6DeadZero9/IW_board_v2.0/IW_board_v2.0.kicad_pcb

## KiCad design IW_board_v2.0.kicad_pcb (2023-08-23)

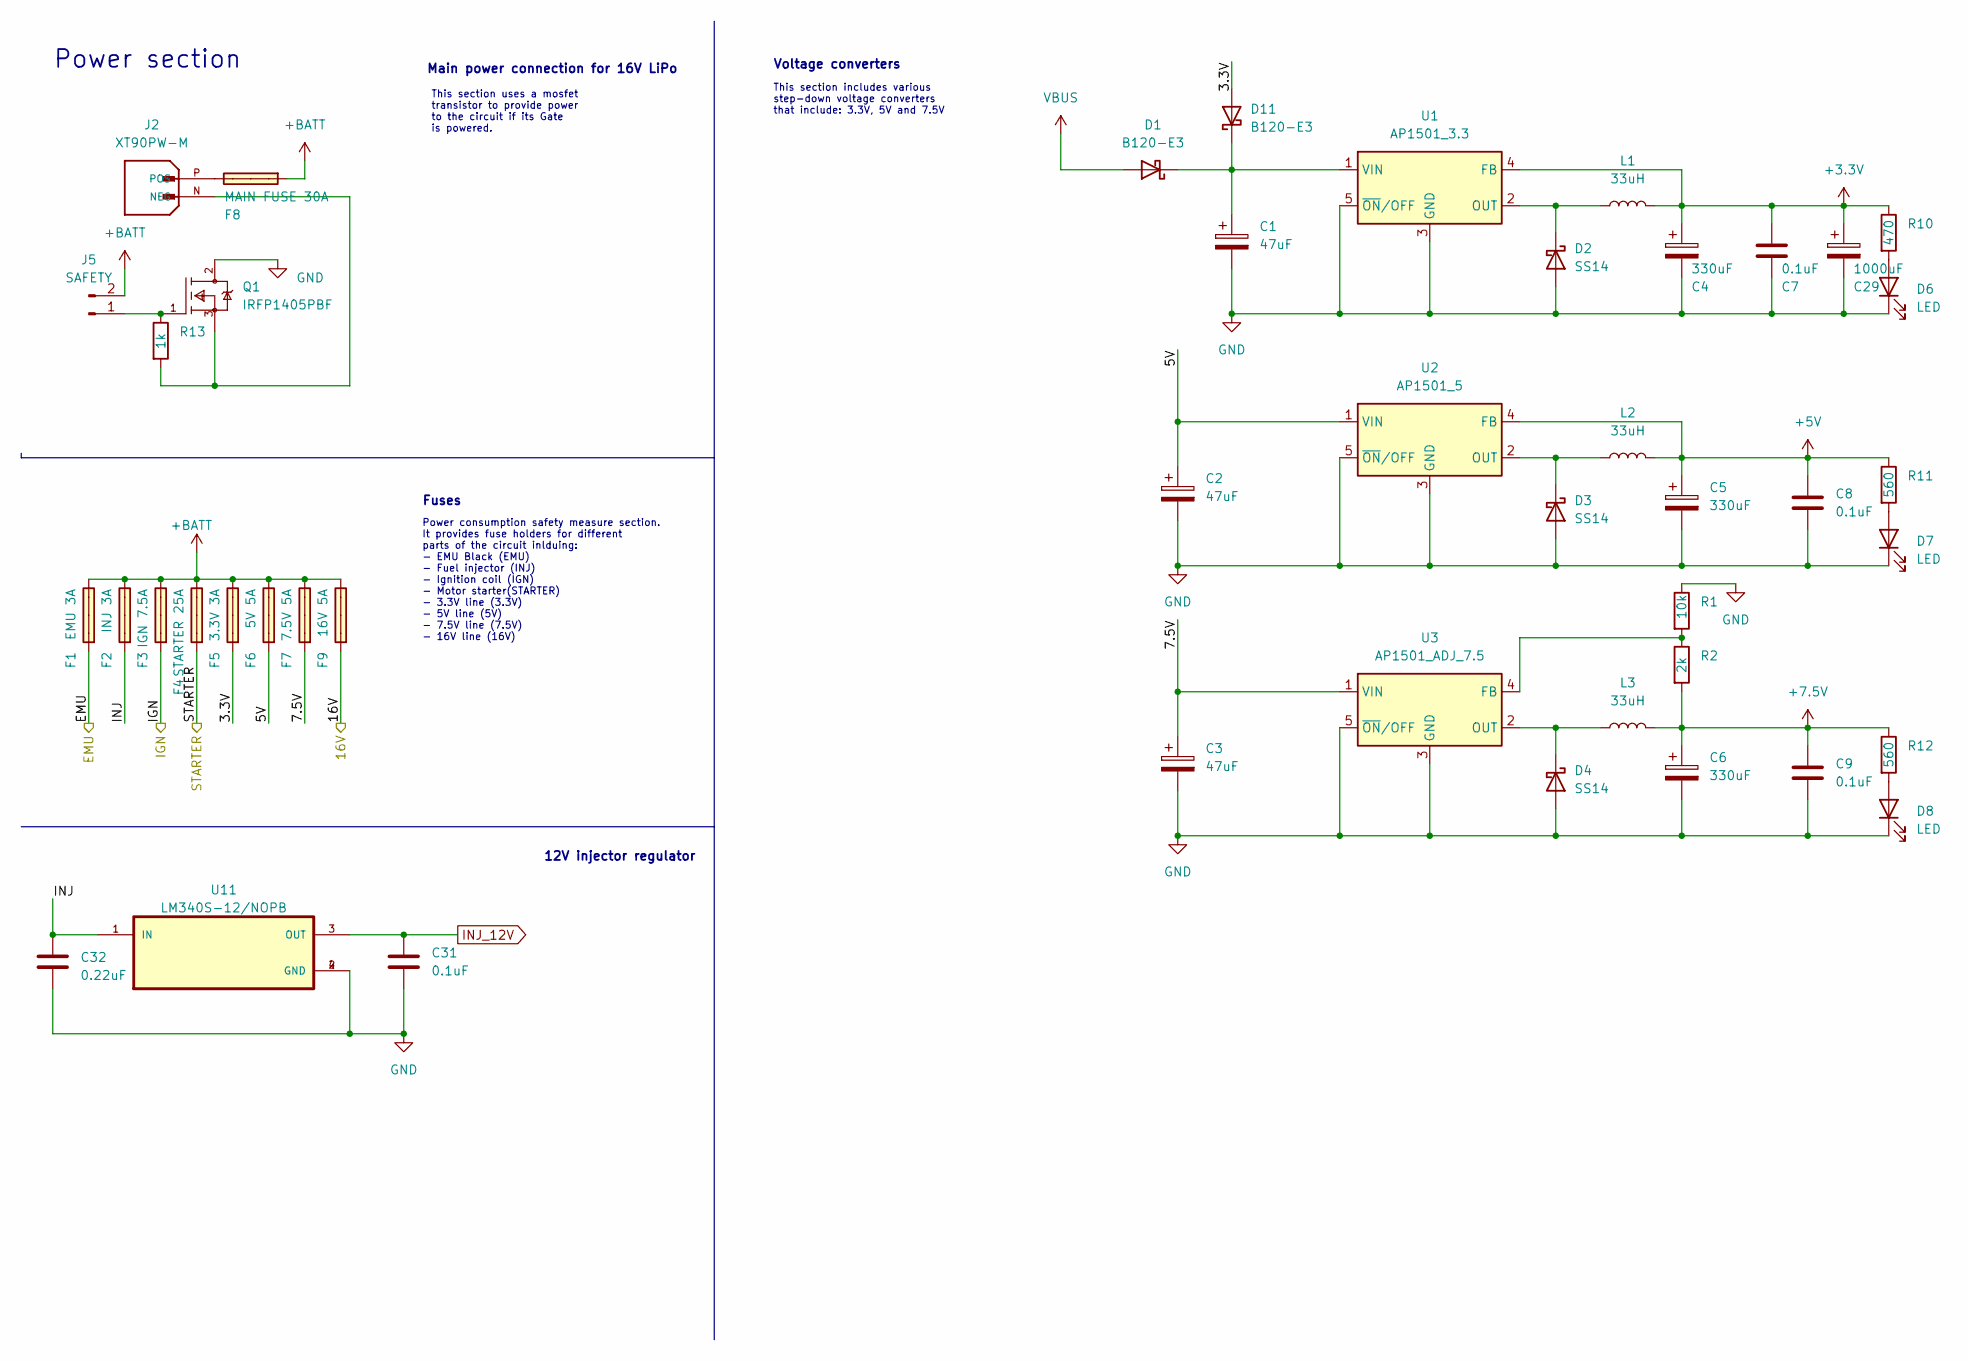
[picture p1: schematic pwr.kicad_sch, Iron Warriors v2.0]

Parts:
C1, C2, C3: 47uF; CP_Elec_6.3x5.8
C4, C5, C6: 330uF; CP_Elec_10x10
C7, C8, C9, C31: 0.1uF; C_0603_1608Metric
C29: 1000uF; CP_Radial_D10.0mm_P7.50mm
C32: 0.22uF; C_0603_1608Metric
D1, D11: B120-E3; D_SMA
D2, D3, D4: SS14; D_SMA
D6, D7, D8: LED; LED_0603_1608Metric
F1: EMU 3A; FUSE_3557-2
F2: INJ 3A; FUSE_3557-2
F3: IGN 7.5A; FUSE_3557-2
F4: STARTER 25A; FUSE_3557-2
F5: 3.3V 3A; FUSE_3557-2
F6: 5V 5A; FUSE_3557-2
F7: 7.5V 5A; FUSE_3557-2
F8: MAIN FUSE 30A; FUSE_3557-2
F9: 16V 5A; FUSE_3557-2
J2: XT90PW-M; AMASS_XT90PW-M
J5: SAFETY; TerminalBlock_Phoenix_MPT-0,5-2-2.54_1x02_P2.54mm_Horizontal
L1, L2, L3: 33uH; L_Bourns_SRR1208_12.7x12.7mm
Q1: IRFP1405PBF; TO247AC; mouser part number 942-IRFP1405PBF; digikey description MOSFET N-CH 55V 95A TO247AC
R1: 10k; R_0603_1608Metric
R2: 2k; R_0603_1608Metric
R10: 470; R_0603_1608Metric
R11, R12: 560; R_0603_1608Metric
R13: 1k; R_0603_1608Metric
U1: AP1501_3.3; TO-263-5_TabPin3
U2: AP1501_5; TO-263-5_TabPin3
U3: AP1501_ADJ_7.5; TO-263-5_TabPin3
U11: LM340S-12/NOPB; TO254P1524X483-4N

Connections:
+3.3V: C4.1, C7.1, C29.1, L1.2, R10.1, U1.4 (FB); also elsewhere on the board
+5V: C5.1, C8.1, L2.2, R11.1, U2.4 (FB); also elsewhere on the board
+7.5V: C6.1, C9.1, L3.2, R2.2, R12.1; also elsewhere on the board
+BATT: F1.3, F2.3, F3.3, F4.3, F5.3, F6.3, F7.3, F8.1, F9.3, J5.2
/IO/EMU: F1.1; also elsewhere on the board
/IO/IGN: F3.1; also elsewhere on the board
/IO/STARTER: F4.1; also elsewhere on the board
/PWR/3.3V: D11.2 (A), F5.1
/PWR/5V: C2.1, F6.1, U2.1 (VIN)
/PWR/7.5V: C3.1, F7.1, U3.1 (VIN)
/PWR/16V: F9.1; also elsewhere on the board
/PWR/INJ: C32.1, F2.1, U11.1 (IN)
GND: C1.2, C2.2, C3.2, C4.2, C5.2, C6.2, C7.2, C8.2, C9.2, C29.2, C31.2, C32.2, D2.2 (A), D3.2 (A), D4.2 (A), D6.1 (K), D7.1 (K), D8.1 (K), Q1.2 (D), R1.1, U1.3 (GND), U1.5 (~ON/OFF), U2.3 (GND), U2.5 (~ON/OFF), U3.3 (GND), U3.5 (~ON/OFF), U11.2 (GND), U11.4 (GND); also elsewhere on the board
INJ_12V: C31.1, U11.3 (OUT); also elsewhere on the board
unnamed: C1.1, D1.1 (K), D11.1 (K), U1.1 (VIN)
unnamed: D2.1 (K), L1.1, U1.2 (OUT)
unnamed: D3.1 (K), L2.1, U2.2 (OUT)
unnamed: D4.1 (K), L3.1, U3.2 (OUT)
unnamed: D6.2 (A), R10.2
unnamed: D7.2 (A), R11.2
unnamed: D8.2 (A), R12.2
unnamed: J2.N (NEG), Q1.3 (S), R13.2
unnamed: F8.3, J2.P (POS)
unnamed: J5.1, Q1.1 (G), R13.1
unnamed: R1.2, R2.1, U3.4 (FB)
VBUS: D1.2 (A); also elsewhere on the board

Notes on the sheet:
This section includes various step-down voltage converters that include: 3.3V, 5V and 7.5V
Power consumption safety measure section. It provides fuse holders for different parts of the circuit inlduing: - EMU Black (EMU) - Fuel injector (INJ) - Ignition coil (IGN) - Motor starter(STARTER) - 3.3V line (3.3V) - 5V line (5V) - 7.5V line (7.5V) - 16V line (16V)
This section uses a mosfet transistor to provide power to the circuit if its Gate is powered.
Power section
12V injector regulator
Main power connection for 16V LiPo
Fuses
Voltage converters

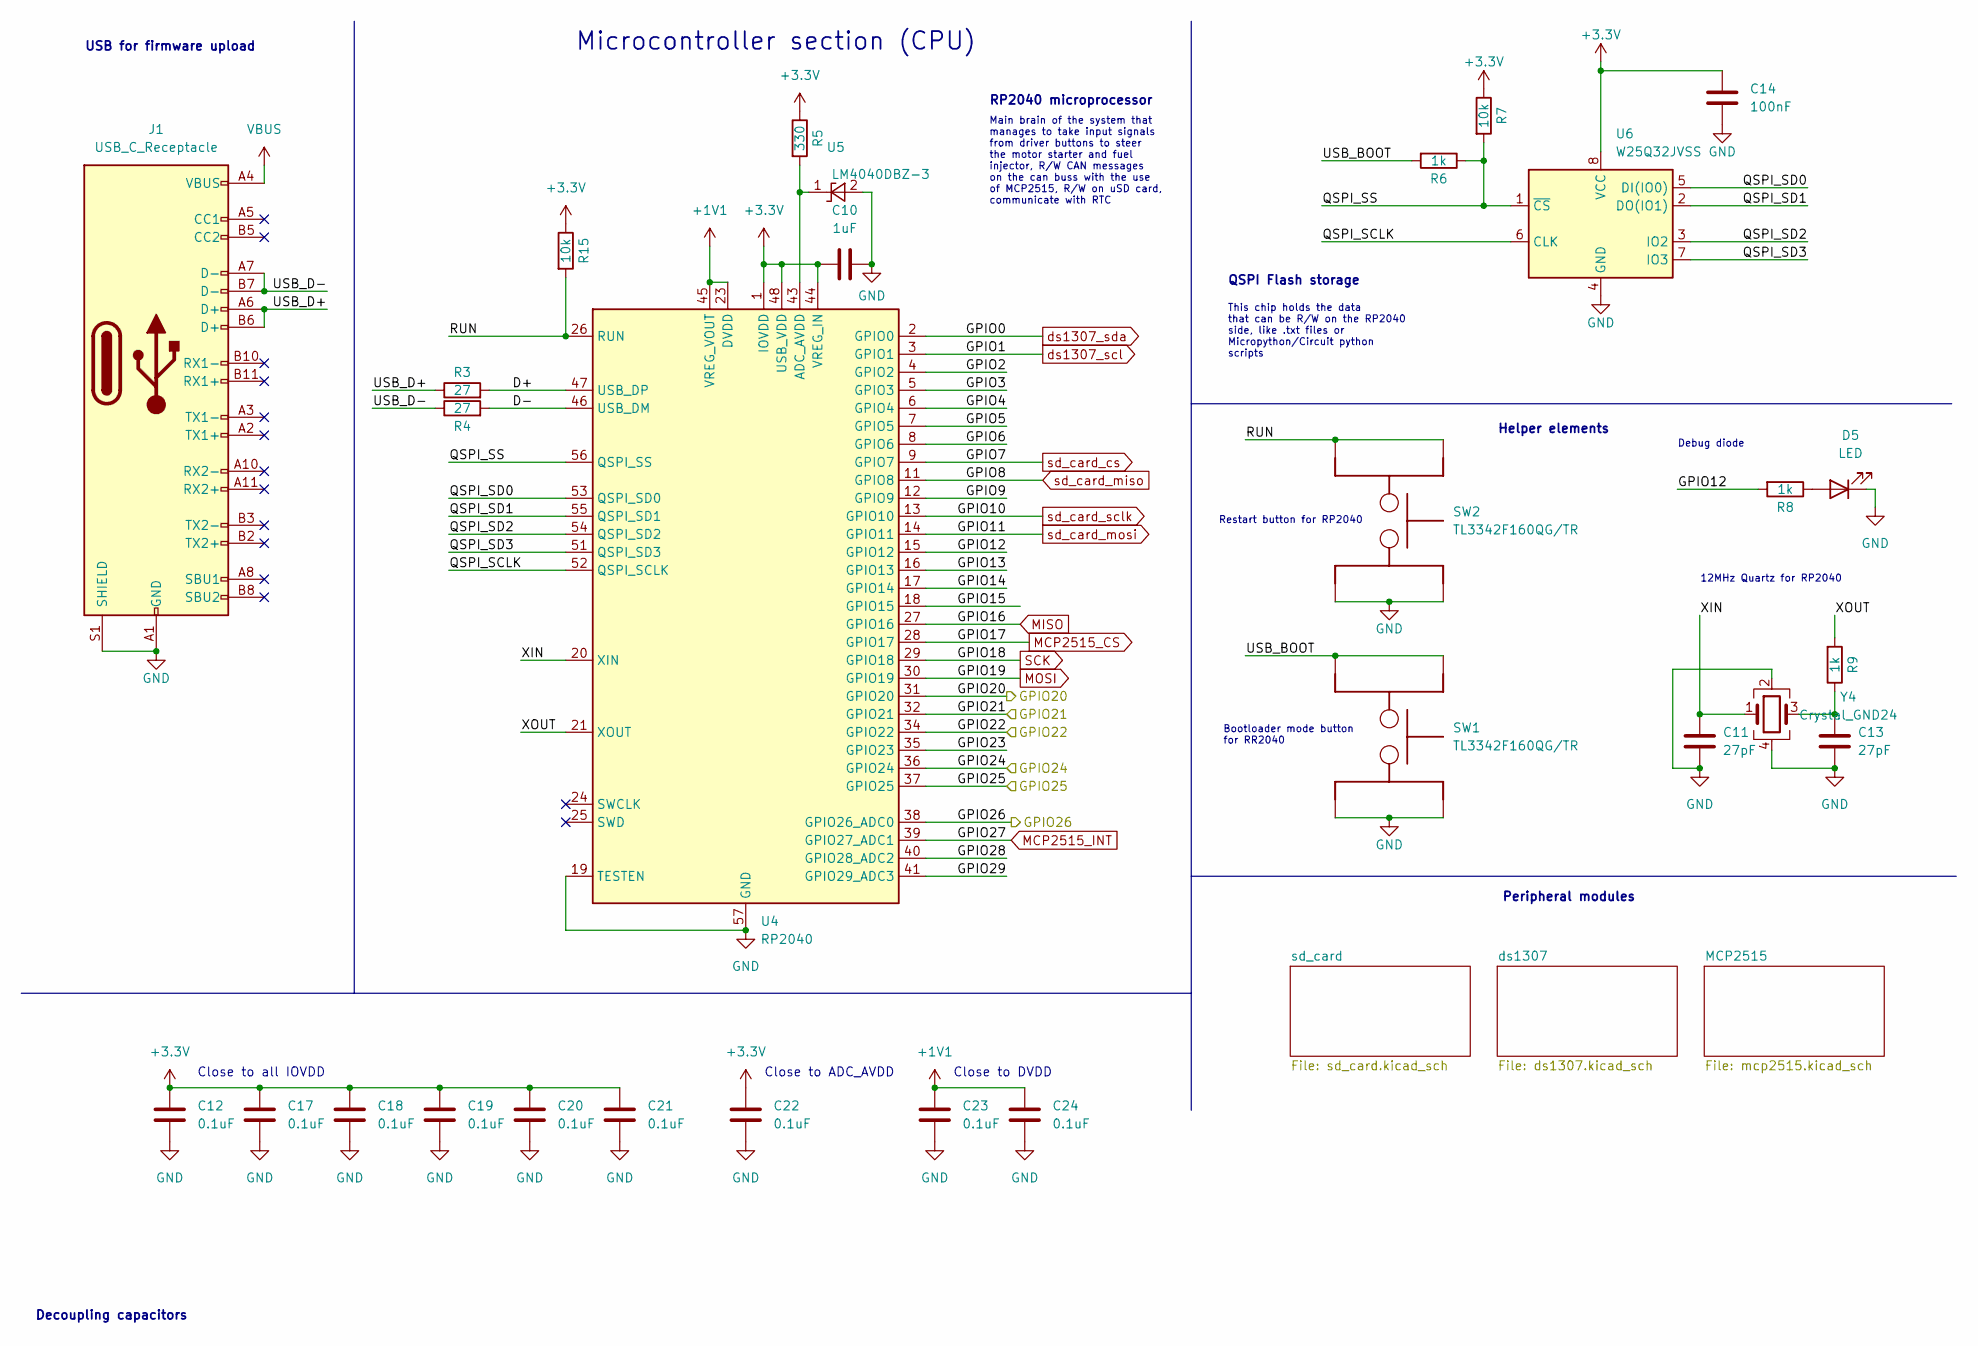
[picture p2: schematic cpu.kicad_sch, Iron Warriors v2.0]

Parts:
C10: 1uF; C_0603_1608Metric
C11, C13: 27pF; C_0603_1608Metric
C12, C17, C18, C19, C20, C21, C22, C23, C24: 0.1uF; C_0603_1608Metric
C14: 100nF; C_0603_1608Metric
D5: LED; LED_0603_1608Metric
J1: USB_C_Receptacle; USB_C_Receptacle_HRO_TYPE-C-31-M-12
R3, R4: 27; R_0603_1608Metric
R5: 330; R_0603_1608Metric
R6, R8, R9: 1k; R_0603_1608Metric
R7, R15: 10k; R_0603_1608Metric
SW1, SW2: TL3342F160QG/TR; SW_TL3342F160QG%2fTR
U4: RP2040; QFN-56-1EP_7x7mm_P0.4mm_EP3.2x3.2mm
U5: LM4040DBZ-3; SOT-23
U6: W25Q32JVSS; SOIC-8_5.23x5.23mm_P1.27mm
Y4: Crystal_GND24

Connections:
+1V1: C23.1, C24.1, U4.23 (DVDD), U4.45 (VREG_VOUT), U4.50 (DVDD)
+3.3V: C10.2, C12.1, C14.1, C17.1, C18.1, C19.1, C20.1, C21.1, C22.1, R5.1, R7.1, R15.1, U4.1 (IOVDD), U4.10 (IOVDD), U4.22 (IOVDD), U4.33 (IOVDD), U4.42 (IOVDD), U4.44 (VREG_IN), U4.48 (USB_VDD), U4.49 (IOVDD), U6.8 (VCC); also elsewhere on the board
/CPU/D+: R3.2, U4.47 (USB_DP)
/CPU/D-: R4.2, U4.46 (USB_DM)
/CPU/GPIO2: U4.4 (GPIO2)
/CPU/GPIO3: U4.5 (GPIO3)
/CPU/GPIO4: U4.6 (GPIO4)
/CPU/GPIO5: U4.7 (GPIO5)
/CPU/GPIO6: U4.8 (GPIO6)
/CPU/GPIO9: U4.12 (GPIO9)
/CPU/GPIO12: R8.2, U4.15 (GPIO12)
/CPU/GPIO13: U4.16 (GPIO13)
/CPU/GPIO14: U4.17 (GPIO14)
/CPU/GPIO15: U4.18 (GPIO15)
/CPU/GPIO20: U4.31 (GPIO20); also elsewhere on the board
/CPU/GPIO21: U4.32 (GPIO21); also elsewhere on the board
/CPU/GPIO22: U4.34 (GPIO22); also elsewhere on the board
/CPU/GPIO23: U4.35 (GPIO23)
/CPU/GPIO24: U4.36 (GPIO24); also elsewhere on the board
/CPU/GPIO25: U4.37 (GPIO25); also elsewhere on the board
/CPU/GPIO26: U4.38 (GPIO26_ADC0); also elsewhere on the board
/CPU/GPIO28: U4.40 (GPIO28_ADC2)
/CPU/GPIO29: U4.41 (GPIO29_ADC3)
/CPU/QSPI_SCLK: U4.52 (QSPI_SCLK), U6.6 (CLK)
/CPU/QSPI_SD0: U4.53 (QSPI_SD0), U6.5 (DI(IO0))
/CPU/QSPI_SD1: U4.55 (QSPI_SD1), U6.2 (DO(IO1))
/CPU/QSPI_SD2: U4.54 (QSPI_SD2), U6.3 (IO2)
/CPU/QSPI_SD3: U4.51 (QSPI_SD3), U6.7 (IO3)
/CPU/QSPI_SS: R6.1, R7.2, U4.56 (QSPI_SS), U6.1 (~CS)
/CPU/RUN: R15.2, SW2.3, SW2.4, U4.26 (RUN)
/CPU/USB_BOOT: R6.2, SW1.3, SW1.4
/CPU/USB_D+: J1.A6 (D+), J1.B6 (D+), R3.1
/CPU/USB_D-: J1.A7 (D-), J1.B7 (D-), R4.1
/CPU/XOUT: R9.2, U4.21 (XOUT)
GND: C10.1, C11.2, C12.2, C13.2, C14.2, C17.2, C18.2, C19.2, C20.2, C21.2, C22.2, C23.2, C24.2, D5.1 (K), J1.A1 (GND), J1.A12 (GND), J1.B1 (GND), J1.B12 (GND), J1.S1 (SHIELD), SW1.1, SW1.2, SW2.1, SW2.2, U4.19 (TESTEN), U4.57 (GND), U5.2 (A), U6.4 (GND), Y4.2, Y4.4; also elsewhere on the board
MCP2515_CS: U4.28 (GPIO17); also elsewhere on the board
MCP2515_INT: U4.39 (GPIO27_ADC1); also elsewhere on the board
MISO: U4.27 (GPIO16); also elsewhere on the board
MOSI: U4.30 (GPIO19); also elsewhere on the board
unnamed: D5.2 (A), R8.1
unnamed: R5.2, U4.43 (ADC_AVDD), U5.1 (K)
SCK: U4.29 (GPIO18); also elsewhere on the board
VBUS: J1.A4 (VBUS), J1.A9 (VBUS), J1.B4 (VBUS), J1.B9 (VBUS); also elsewhere on the board
ds1307_scl: U4.3 (GPIO1); also elsewhere on the board
ds1307_sda: U4.2 (GPIO0); also elsewhere on the board
sd_card_cs: U4.9 (GPIO7); also elsewhere on the board
sd_card_miso: U4.11 (GPIO8); also elsewhere on the board
sd_card_mosi: U4.14 (GPIO11); also elsewhere on the board
sd_card_sclk: U4.13 (GPIO10); also elsewhere on the board

Notes on the sheet:
Peripheral modules
Bootloader mode button for RR2040
RP2040 microprocessor
This chip holds the data that can be R/W on the RP2040 side, like .txt files or Micropython/Circuit python scripts
Close to DVDD
Close to all IOVDD
Close to ADC_AVDD
Debug diode
Decoupling capacitors
Restart button for RP2040
USB for firmware upload
Microcontroller section (CPU)
Helper elements
QSPI Flash storage
Main brain of the system that manages to take input signals from driver buttons to steer the motor starter and fuel injector, R/W CAN messages on the can buss with the use of MCP2515, R/W on uSD card, communicate with RTC
12MHz Quartz for RP2040

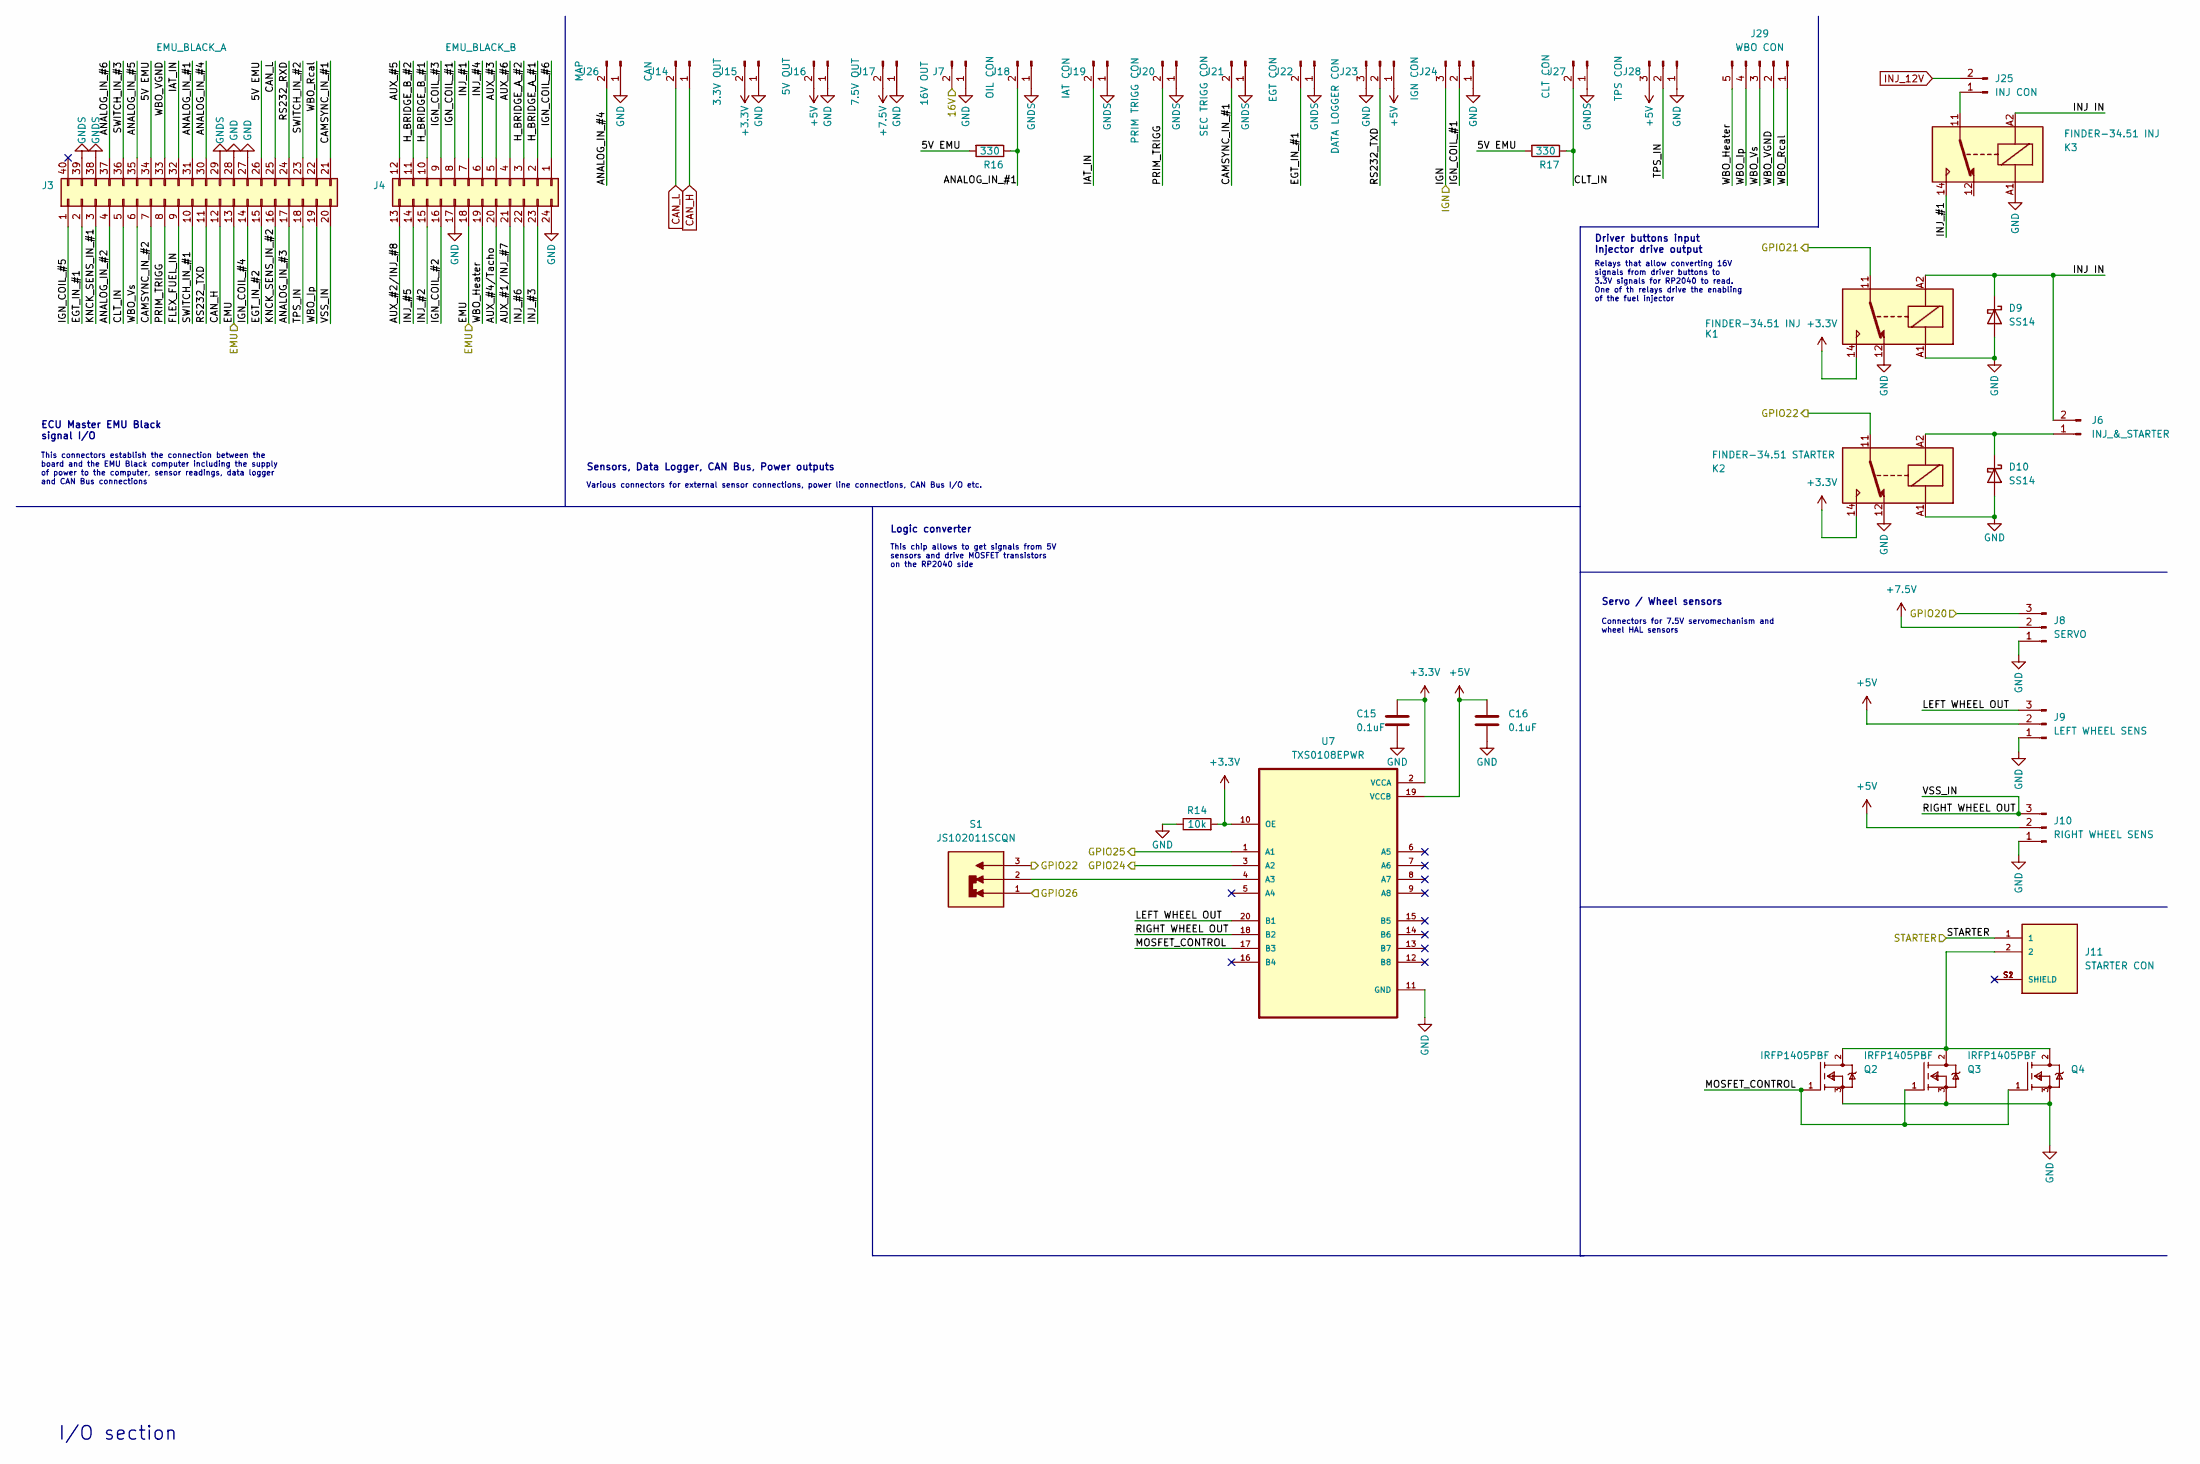
[picture p3: schematic io.kicad_sch, Iron Warriors v2.0]

Parts:
C15, C16: 0.1uF; C_0603_1608Metric
D9, D10: SS14; D_SMA
J3: EMU_BLACK_A; IDC-Header_2x20_P2.54mm_Vertical
J4: EMU_BLACK_B; IDC-Header_2x12_P2.54mm_Vertical
J6: INJ_&_STARTER; TerminalBlock_Phoenix_MPT-0,5-2-2.54_1x02_P2.54mm_Horizontal
J7: 16V OUT; TerminalBlock_Phoenix_MPT-0,5-2-2.54_1x02_P2.54mm_Horizontal
J8: SERVO; TerminalBlock_Phoenix_MPT-0,5-3-2.54_1x03_P2.54mm_Horizontal
J9: LEFT WHEEL SENS; TerminalBlock_Phoenix_MPT-0,5-3-2.54_1x03_P2.54mm_Horizontal
J10: RIGHT WHEEL SENS; TerminalBlock_Phoenix_MPT-0,5-3-2.54_1x03_P2.54mm_Horizontal
J11: STARTER CON; AMASS_XT60PW-F
J14: CAN; TerminalBlock_Phoenix_MPT-0,5-2-2.54_1x02_P2.54mm_Horizontal
J15: 3.3V OUT; TerminalBlock_Phoenix_MPT-0,5-2-2.54_1x02_P2.54mm_Horizontal
J16: 5V OUT; TerminalBlock_Phoenix_MPT-0,5-2-2.54_1x02_P2.54mm_Horizontal
J17: 7.5V OUT; TerminalBlock_Phoenix_MPT-0,5-2-2.54_1x02_P2.54mm_Horizontal
J18: OIL CON; TerminalBlock_Phoenix_MPT-0,5-2-2.54_1x02_P2.54mm_Horizontal
J19: IAT CON; TerminalBlock_Phoenix_MPT-0,5-2-2.54_1x02_P2.54mm_Horizontal
J20: PRIM TRIGG CON; TerminalBlock_Phoenix_MPT-0,5-2-2.54_1x02_P2.54mm_Horizontal
J21: SEC TRIGG CON; TerminalBlock_Phoenix_MPT-0,5-2-2.54_1x02_P2.54mm_Horizontal
J22: EGT CON; TerminalBlock_Phoenix_MPT-0,5-2-2.54_1x02_P2.54mm_Horizontal
J23: DATA LOGGER CON; TerminalBlock_Phoenix_MPT-0,5-3-2.54_1x03_P2.54mm_Horizontal
J24: IGN CON; TerminalBlock_Phoenix_MPT-0,5-3-2.54_1x03_P2.54mm_Horizontal
J25: INJ CON; TerminalBlock_Phoenix_MPT-0,5-2-2.54_1x02_P2.54mm_Horizontal
J26: MAP; TerminalBlock_Phoenix_MPT-0,5-2-2.54_1x02_P2.54mm_Horizontal
J27: CLT CON; TerminalBlock_Phoenix_MPT-0,5-2-2.54_1x02_P2.54mm_Horizontal
J28: TPS CON; TerminalBlock_Phoenix_MPT-0,5-3-2.54_1x03_P2.54mm_Horizontal
J29: WBO CON; TerminalBlock_Phoenix_MPT-0,5-5-2.54_1x05_P2.54mm_Horizontal
K1, K3: FINDER-34.51 INJ; Relay_SPDT_Finder_34.51_Vertical
K2: FINDER-34.51 STARTER; Relay_SPDT_Finder_34.51_Vertical
Q2, Q3, Q4: IRFP1405PBF; TO247AC; mouser part number 942-IRFP1405PBF; digikey description MOSFET N-CH 55V 95A TO247AC
R14: 10k; R_0603_1608Metric
R16, R17: 330; R_0603_1608Metric
S1: JS102011SCQN; SW_JS102011SCQN; PARTREV 8 Oct 21
U7: TXS0108EPWR; SOP65P640X120-20N

Connections:
+3.3V: C15.2, J15.2, K1.14, K2.14, R14.2, U7.2 (VCCA), U7.10 (OE); also elsewhere on the board
+5V: C16.2, J9.2, J10.2, J16.2, J23.1, J28.3, U7.19 (VCCB); also elsewhere on the board
+7.5V: J8.2, J17.2; also elsewhere on the board
/CPU/GPIO20: J8.3; also elsewhere on the board
/CPU/GPIO21: K1.11; also elsewhere on the board
/CPU/GPIO22: K2.11, S1.3; also elsewhere on the board
/CPU/GPIO24: U7.3 (A2); also elsewhere on the board
/CPU/GPIO25: U7.1 (A1); also elsewhere on the board
/CPU/GPIO26: S1.1; also elsewhere on the board
/IO/5V EMU: J3.26, J3.34, R16.2, R17.2
/IO/ANALOG_IN_#1: J3.31, J18.2, R16.1
/IO/ANALOG_IN_#2: J3.4
/IO/ANALOG_IN_#3: J3.17
/IO/ANALOG_IN_#4: J3.30, J26.2
/IO/ANALOG_IN_#5: J3.35
/IO/ANALOG_IN_#6: J3.37
/IO/AUX_#1/INJ_#7: J4.21
/IO/AUX_#2/INJ_#8: J4.13
/IO/AUX_#3: J4.5
/IO/AUX_#4/Tacho: J4.20
/IO/AUX_#5: J4.12
/IO/AUX_#6: J4.4
/IO/CAMSYNC_IN_#1: J3.21, J21.2
/IO/CAMSYNC_IN_#2: J3.7
/IO/CLT_IN: J3.5, J27.2, R17.1
/IO/EGT_IN_#1: J3.2, J22.2
/IO/EGT_IN_#2: J3.15
/IO/EMU: J3.13, J4.18; also elsewhere on the board
/IO/FLEX_FUEL_IN: J3.9
/IO/H_BRIDGE_A_#1: J4.2
/IO/H_BRIDGE_A_#2: J4.3
/IO/H_BRIDGE_B_#1: J4.10
/IO/H_BRIDGE_B_#2: J4.11
/IO/IAT_IN: J3.32, J19.2
/IO/IGN: J24.3; also elsewhere on the board
/IO/IGN_COIL_#1: J4.8, J24.2
/IO/IGN_COIL_#2: J4.16
/IO/IGN_COIL_#3: J4.9
/IO/IGN_COIL_#4: J3.14
/IO/IGN_COIL_#5: J3.1
/IO/IGN_COIL_#6: J4.1
/IO/INJ IN: D9.1 (K), J6.2, K1.A2, K3.A2
/IO/INJ_#1: J4.7, K3.14
/IO/INJ_#2: J4.15
/IO/INJ_#3: J4.23
/IO/INJ_#4: J4.6
/IO/INJ_#5: J4.14
/IO/INJ_#6: J4.22
/IO/KNCK_SENS_IN_#1: J3.3
/IO/KNCK_SENS_IN_#2: J3.16
/IO/LEFT WHEEL OUT: J9.3, U7.20 (B1)
/IO/MOSFET_CONTROL: Q2.1 (G), Q3.1 (G), Q4.1 (G), U7.17 (B3)
/IO/PRIM_TRIGG: J3.8, J20.2
/IO/RIGHT WHEEL OUT: J3.20, J10.3, U7.18 (B2)
/IO/RS232_RXD: J3.24
/IO/RS232_TXD: J3.11, J23.2
/IO/STARTER: J11.1; also elsewhere on the board
/IO/SWITCH_IN_#1: J3.10
/IO/SWITCH_IN_#2: J3.23
/IO/SWITCH_IN_#3: J3.36
/IO/TPS_IN: J3.18, J28.2
/IO/WBO_Heater: J4.19, J29.5
/IO/WBO_Ip: J3.19, J29.4
/IO/WBO_Rcal: J3.22, J29.1
/IO/WBO_VGND: J3.33, J29.2
/IO/WBO_Vs: J3.6, J29.3
/PWR/16V: J7.2; also elsewhere on the board
CAN_H: J3.12, J14.1; also elsewhere on the board
CAN_L: J3.25, J14.2; also elsewhere on the board
GND: C15.1, C16.1, D9.2 (A), D10.2 (A), J3.27, J3.28, J4.17, J4.24, J7.1, J8.1, J9.1, J10.1, J15.1, J16.1, J17.1, J23.3, J24.1, J26.1, J28.1, K1.12, K1.A1, K2.12, K2.A1, K3.A1, Q2.3 (S), Q3.3 (S), Q4.3 (S), R14.1, U7.11 (GND); also elsewhere on the board
GNDS: J3.29, J3.38, J3.39, J18.1, J19.1, J20.1, J21.1, J22.1, J27.1
INJ_12V: J25.2; also elsewhere on the board
unnamed: D10.1 (K), J6.1, K2.A2
unnamed: J25.1, K3.11
unnamed: J11.2, Q2.2 (D), Q3.2 (D), Q4.2 (D)
unnamed: S1.2, U7.4 (A3)

Notes on the sheet:
This connectors establish the connection between the board and the EMU Black computer including the supply of power to the computer, sensor readings, data logger and CAN Bus connections
This chip allows to get signals from 5V sensors and drive MOSFET transistors on the RP2040 side
ECU Master EMU Black signal I/O
Servo / Wheel sensors
Connectors for 7.5V servomechanism and wheel HAL sensors
Sensors, Data Logger, CAN Bus, Power outputs
Driver buttons input Injector drive output
Relays that allow converting 16V signals from driver buttons to 3.3V signals for RP2040 to read. One of th relays drive the enabling of the fuel injector
Various connectors for external sensor connections, power line connections, CAN Bus I/O etc.
I/O section
Logic converter

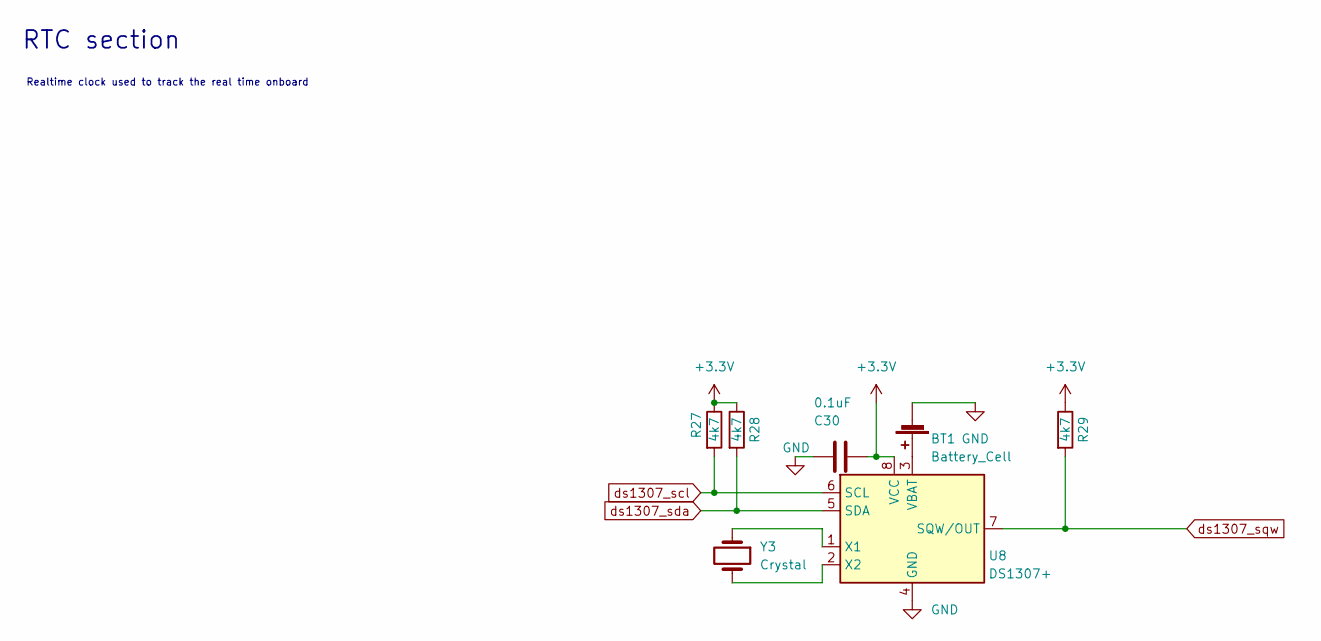
[picture p4: schematic ds1307.kicad_sch, Iron Warriors v2.0]

Parts:
BT1: Battery_Cell; BatteryHolder_Keystone_3034_1x20mm
C30: 0.1uF; C_0603_1608Metric
R27, R28, R29: 4k7; R_0603_1608Metric
U8: DS1307+; SOIC-8_3.9x4.9mm_P1.27mm
Y3: Crystal; Crystal_SMD_3215-2Pin_3.2x1.5mm

Connections:
+3.3V: C30.1, R27.1, R28.1, R29.1, U8.8 (VCC); also elsewhere on the board
GND: BT1.2 (-), C30.2, U8.4 (GND); also elsewhere on the board
unnamed: BT1.1 (+), U8.3 (VBAT)
unnamed: U8.1 (X1), Y3.1
unnamed: U8.2 (X2), Y3.2
ds1307_scl: R27.2, U8.6 (SCL); also elsewhere on the board
ds1307_sda: R28.2, U8.5 (SDA); also elsewhere on the board
ds1307_sqw: R29.2, U8.7 (SQW/OUT)

Notes on the sheet:
Realtime clock used to track the real time onboard
RTC section

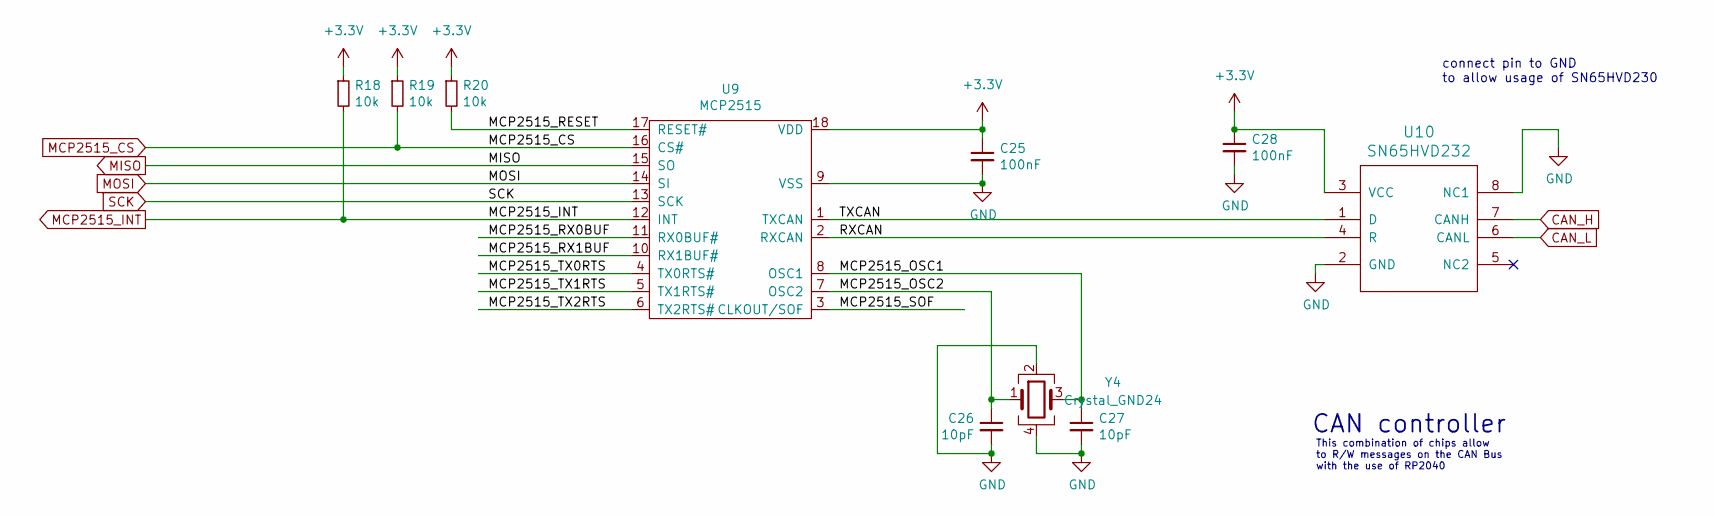
[picture p5: schematic mcp2515.kicad_sch, Iron Warriors v2.0]

Parts:
C25, C28: 100nF; C_0603_1608Metric
C26, C27: 10pF; C_0603_1608Metric
R18, R19, R20: 10k; R_0603_1608Metric
U9: MCP2515; SOIC-18W_7.5x11.6mm_P1.27mm
U10: SN65HVD232; SOIC-8_3.9x4.9mm_P1.27mm
Y4: Crystal_GND24

Connections:
+3.3V: C25.1, C28.1, R18.1, R19.1, R20.1, U9.18 (VDD), U10.3 (VCC); also elsewhere on the board
/CPU/MCP2515/MCP2515_RESET: R20.2, U9.17 (RESET#)
/CPU/MCP2515/MCP2515_RX0BUF: U9.11 (RX0BUF#)
/CPU/MCP2515/MCP2515_RX1BUF: U9.10 (RX1BUF#)
/CPU/MCP2515/MCP2515_SOF: U9.3 (CLKOUT/SOF)
/CPU/MCP2515/MCP2515_TX0RTS: U9.4 (TX0RTS#)
/CPU/MCP2515/MCP2515_TX1RTS: U9.5 (TX1RTS#)
/CPU/MCP2515/MCP2515_TX2RTS: U9.6 (TX2RTS#)
/CPU/MCP2515/RXCAN: U9.2 (RXCAN), U10.4 (R)
/CPU/MCP2515/TXCAN: U9.1 (TXCAN), U10.1 (D)
CAN_H: U10.7 (CANH); also elsewhere on the board
CAN_L: U10.6 (CANL); also elsewhere on the board
GND: C25.2, C26.2, C27.2, C28.2, U9.9 (VSS), U10.2 (GND), U10.8 (NC1), Y4.2, Y4.4; also elsewhere on the board
MCP2515_CS: R19.2, U9.16 (CS#); also elsewhere on the board
MCP2515_INT: R18.2, U9.12 (INT); also elsewhere on the board
MISO: U9.15 (SO); also elsewhere on the board
MOSI: U9.14 (SI); also elsewhere on the board
SCK: U9.13 (SCK); also elsewhere on the board

Notes on the sheet:
CAN controller
This combination of chips allow to R/W messages on the CAN Bus with the use of RP2040
connect pin to GND to allow usage of SN65HVD230

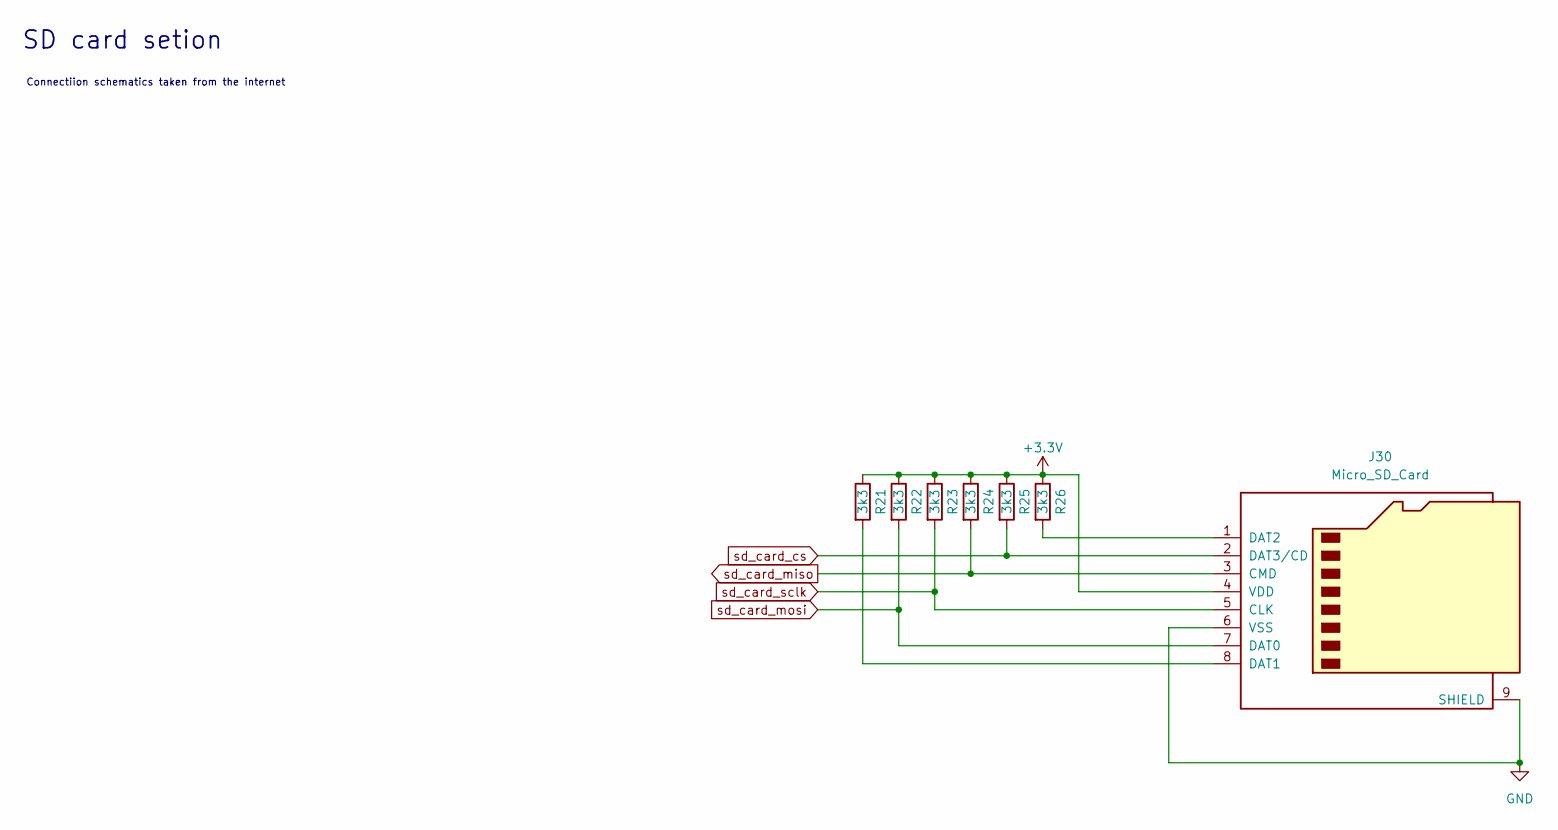
[picture p6: schematic sd_card.kicad_sch, Iron Warriors v2.0]

Parts:
J30: Micro_SD_Card; 112J-TDAR-R01
R21, R22, R23, R24, R25, R26: 3k3; R_0603_1608Metric

Connections:
+3.3V: J30.4 (VDD), R21.1, R22.1, R23.1, R24.1, R25.1, R26.1; also elsewhere on the board
GND: J30.6 (VSS), J30.9 (SHIELD); also elsewhere on the board
unnamed: J30.8 (DAT1), R21.2
unnamed: J30.1 (DAT2), R26.2
sd_card_cs: J30.2 (DAT3/CD), R25.2; also elsewhere on the board
sd_card_miso: J30.3 (CMD), R24.2; also elsewhere on the board
sd_card_mosi: J30.7 (DAT0), R22.2; also elsewhere on the board
sd_card_sclk: J30.5 (CLK), R23.2; also elsewhere on the board

Notes on the sheet:
SD card setion
Connectiion schematics taken from the internet

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
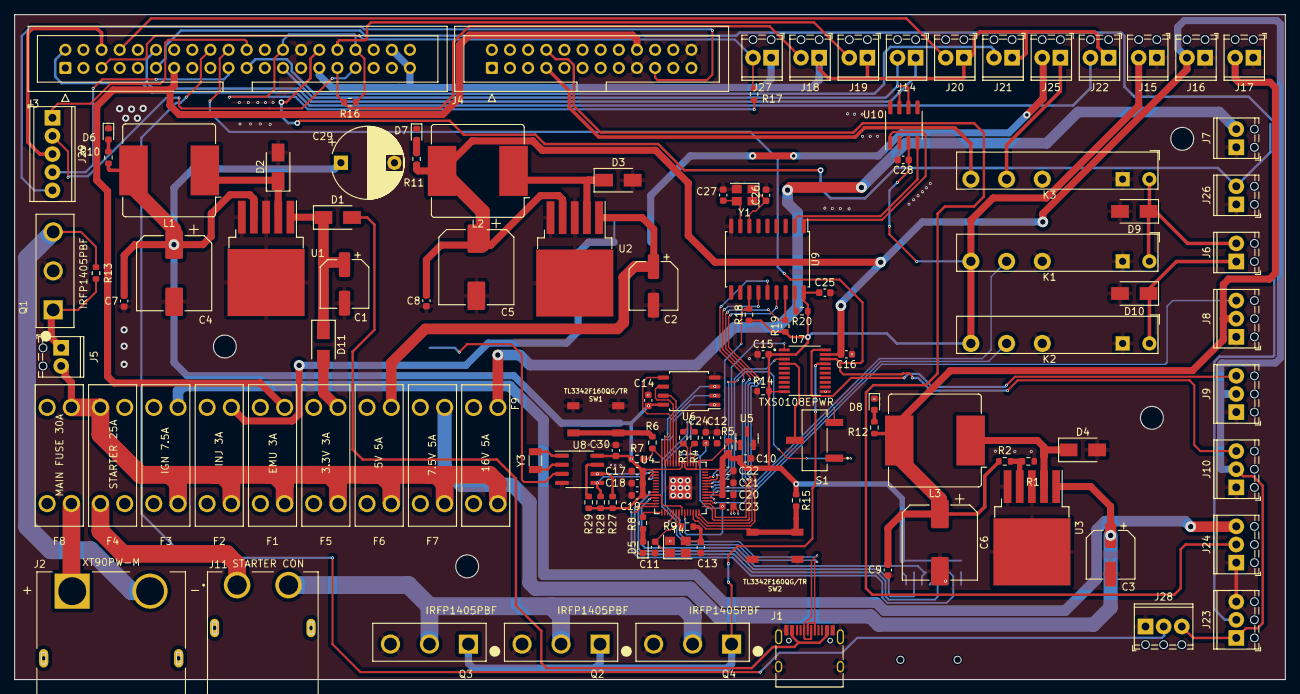
[picture p7: board IW_board_v2.0.kicad_pcb from above]

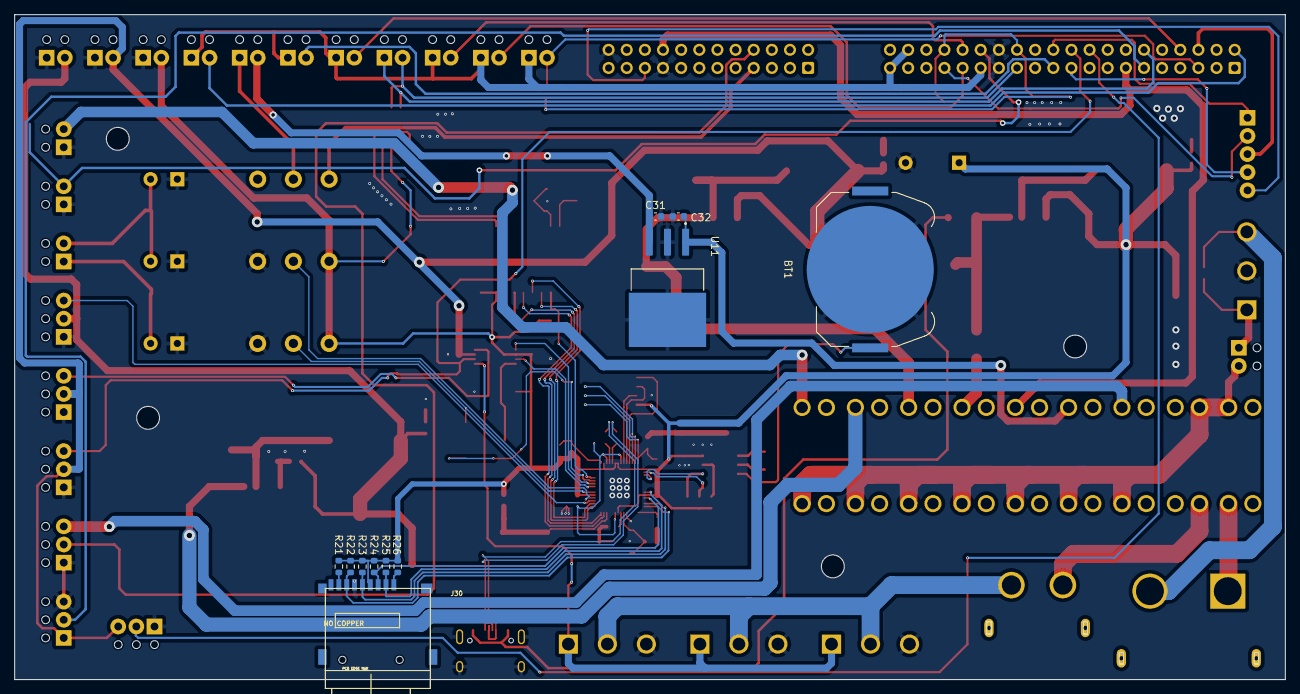
[picture p8: board IW_board_v2.0.kicad_pcb from below]

Board: 2 copper layers, 177.9 x 93.1 mm, 137 parts (11 on the bottom side), 101 nets.

Other parts of the board:
Y1: Crystal_GND24; Crystal_SMD_3225-4Pin_3.2x2.5mm

Their connections:
GND: Y1.2, Y1.4; also elsewhere on the board
