6DeadZero9/IW_board_v2.0/(commit log)

2022-12-06 Basic schematic edited
    [IW_board_v2.0.kicad_sch, cpu.kicad_sch, io.kicad_sch, pwr.kicad_sch]
2022-12-06 Expanded IO
    [IW_board_v2.0.kicad_sch, cpu.kicad_sch, io.kicad_sch, pwr.kicad_sch]
2022-12-08 Rev 1.0
    [IW_board_v2.0.kicad_sch, cpu.kicad_sch, io.kicad_sch, pwr.kicad_sch]
2022-12-13 Initial PCB view
    [IW_board_v2.0.kicad_pcb, IW_board_v2.0.kicad_sch, cpu.kicad_sch, io.kicad_sch, pwr.kicad_sch]
2023-01-09 First full version of the PCB
    [IW_board_v2.0.kicad_pcb, IW_board_v2.0.kicad_sch, cpu.kicad_sch, io.kicad_sch, pwr.kicad_sch]
2023-04-19 Small corrections
    [IW_board_v2.0.kicad_pcb, IW_board_v2.0.kicad_sch, cpu.kicad_sch, io.kicad_sch, pwr.kicad_sch]
2023-05-02 Added CAN transsiver to RP2040
    [IW_board_v2.0.kicad_pcb, IW_board_v2.0.kicad_sch, cpu.kicad_sch, io.kicad_sch, mcp2515.kicad_sch, pwr.kicad_sch]
2023-05-29 Added lambda connection, switching between PWM and 3.3v signal to drive mosfets.
    [IW_board_v2.0.kicad_pcb, IW_board_v2.0.kicad_sch, io.kicad_sch, pwr.kicad_sch]
2023-07-26 Added DS1307 RTC and micro SD card
    [IW_board_v2.0.kicad_pcb, IW_board_v2.0.kicad_sch, cpu.kicad_sch, ds1307.kicad_sch, io.kicad_sch, mcp2515.kicad_sch, pwr.kicad_sch, sd_card.kicad_sch]
2023-08-01 Added schematic descriptions
    [IW_board_v2.0.kicad_sch, cpu.kicad_sch, ds1307.kicad_sch, io.kicad_sch, mcp2515.kicad_sch, pwr.kicad_sch, sd_card.kicad_sch]
2023-08-23 Added 12V regulator for injector
    [IW_board_v2.0.kicad_pcb, IW_board_v2.0.kicad_sch, cpu.kicad_sch, ds1307.kicad_sch, io.kicad_sch, mcp2515.kicad_sch, pwr.kicad_sch, sd_card.kicad_sch]
